ukinori/flightcontroller/placement-preview.png

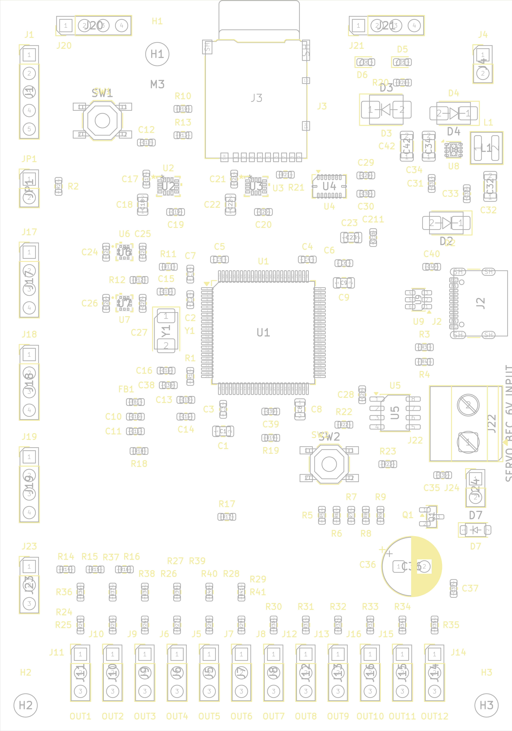
placement-preview.png
