ukinori/flightcontroller/CRYSTAL-DECOUPLING-BOM.csv

Reference | Value | Voltage | Dielectric | Tolerance | Manufacturer | MPN | Footprint
C17 | 100n | 25V | X7R | 10% | Murata | GRM188R71E104KA01D | Capacitor_SMD:C_0603_1608Metric
C21 | 100n | 25V | X7R | 10% | Murata | GRM188R71E104KA01D | Capacitor_SMD:C_0603_1608Metric
C28 | 100n | 25V | X7R | 10% | Murata | GRM188R71E104KA01D | Capacitor_SMD:C_0603_1608Metric
C18 | 2.2u | 16V | X7R | 10% | Murata | GRM21BR71C225KA12L | Capacitor_SMD:C_0805_2012Metric
C22 | 2.2u | 16V | X7R | 10% | Murata | GRM21BR71C225KA12L | Capacitor_SMD:C_0805_2012Metric
C15 | 18p | 50V | C0G | 5% | Murata | GRM1885C1H180JA01D | Capacitor_SMD:C_0603_1608Metric
C16 | 18p | 50V | C0G | 5% | Murata | GRM1885C1H180JA01D | Capacitor_SMD:C_0603_1608Metric
Y1 | 8MHz |  |  |  | Abracon | ABM3-8.000MHZ-12-D4Y-T | Crystal:Crystal_SMD_Abracon_ABM3-2Pin_5.0x3.2mm
