ukinori/flightcontroller/POWER-CAPACITORS-BOM.csv

Reference | Value | Voltage | Dielectric | Tolerance | Manufacturer | MPN | Footprint
C31 | 100n | 25V | X7R | 10% | Murata | GRM188R71E104KA01D | Capacitor_SMD:C_0603_1608Metric
C33 | 100n | 25V | X7R | 10% | Murata | GRM188R71E104KA01D | Capacitor_SMD:C_0603_1608Metric
C32 | 22u | 10V | X7R | 10% | Murata | GRM31CR71A226KE15L | Capacitor_SMD:C_1206_3216Metric
C34 | 10u | 25V | X7R | 10% | Murata | GRM31CR71E106KA12L | Capacitor_SMD:C_1206_3216Metric
C42 | 10u | 25V | X7R | 10% | Murata | GRM31CR71E106KA12L | Capacitor_SMD:C_1206_3216Metric
