ukinori/flightcontroller/models/BMP390-envelope.step

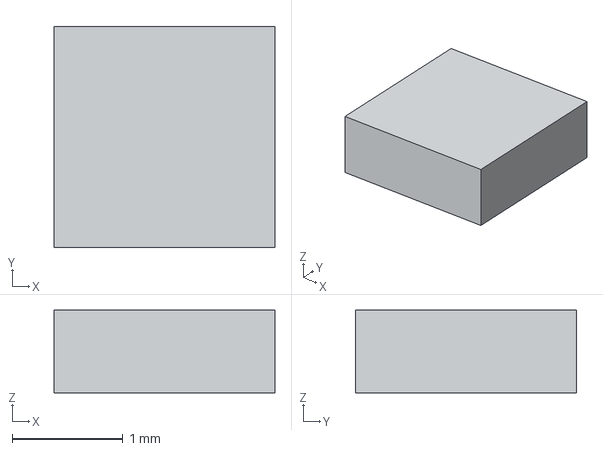
[picture p3: CAD file, 2026-10-22]
models/BMP390-envelope.step
2.00 x 2.00 x 0.75 mm
