ukinori/flightcontroller/models/ICM42688-envelope.step

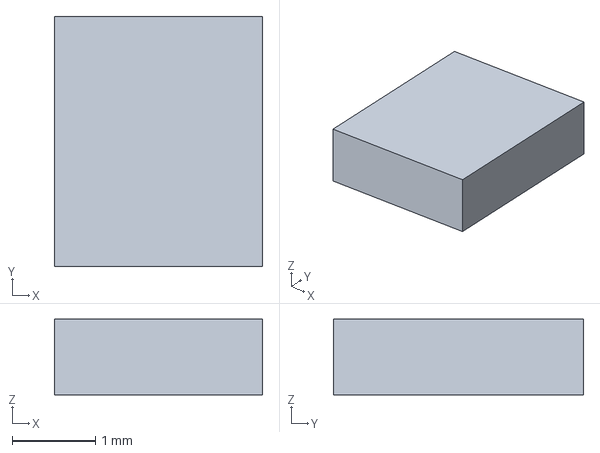
[picture p4: CAD file, 2026-10-22]
models/ICM42688-envelope.step
2.50 x 3.00 x 0.91 mm
