ukinori/flightcontroller/flightcontroller.kicad_pcb

## KiCad design flightcontroller.kicad_pcb (2026-10-22)

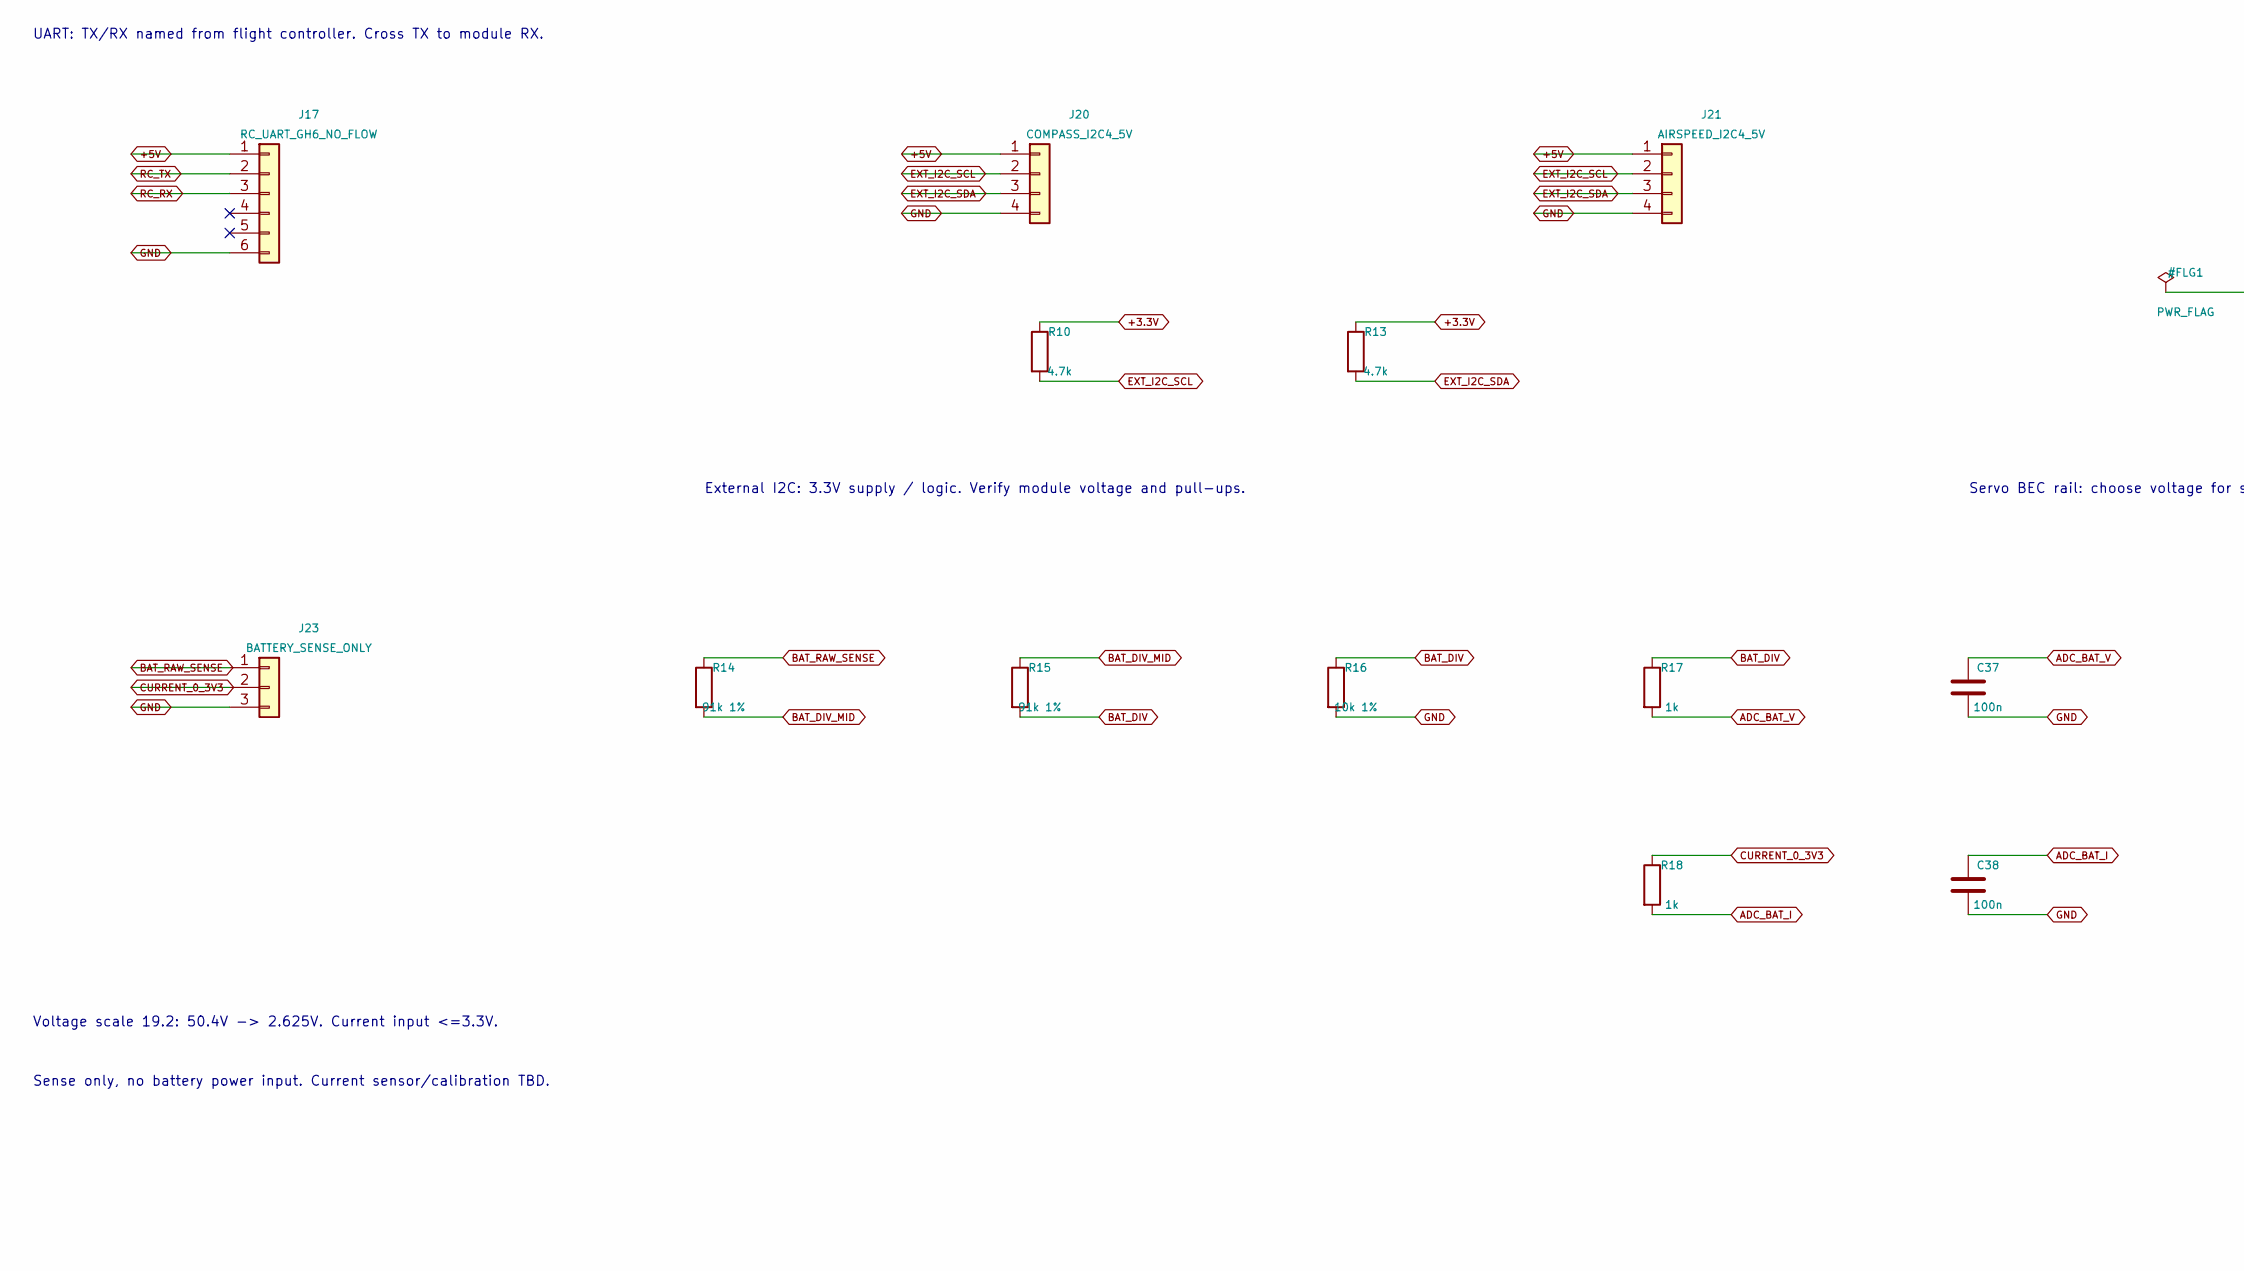
[picture p5: schematic interfaces.kicad_sch, part in row 1, column 1]

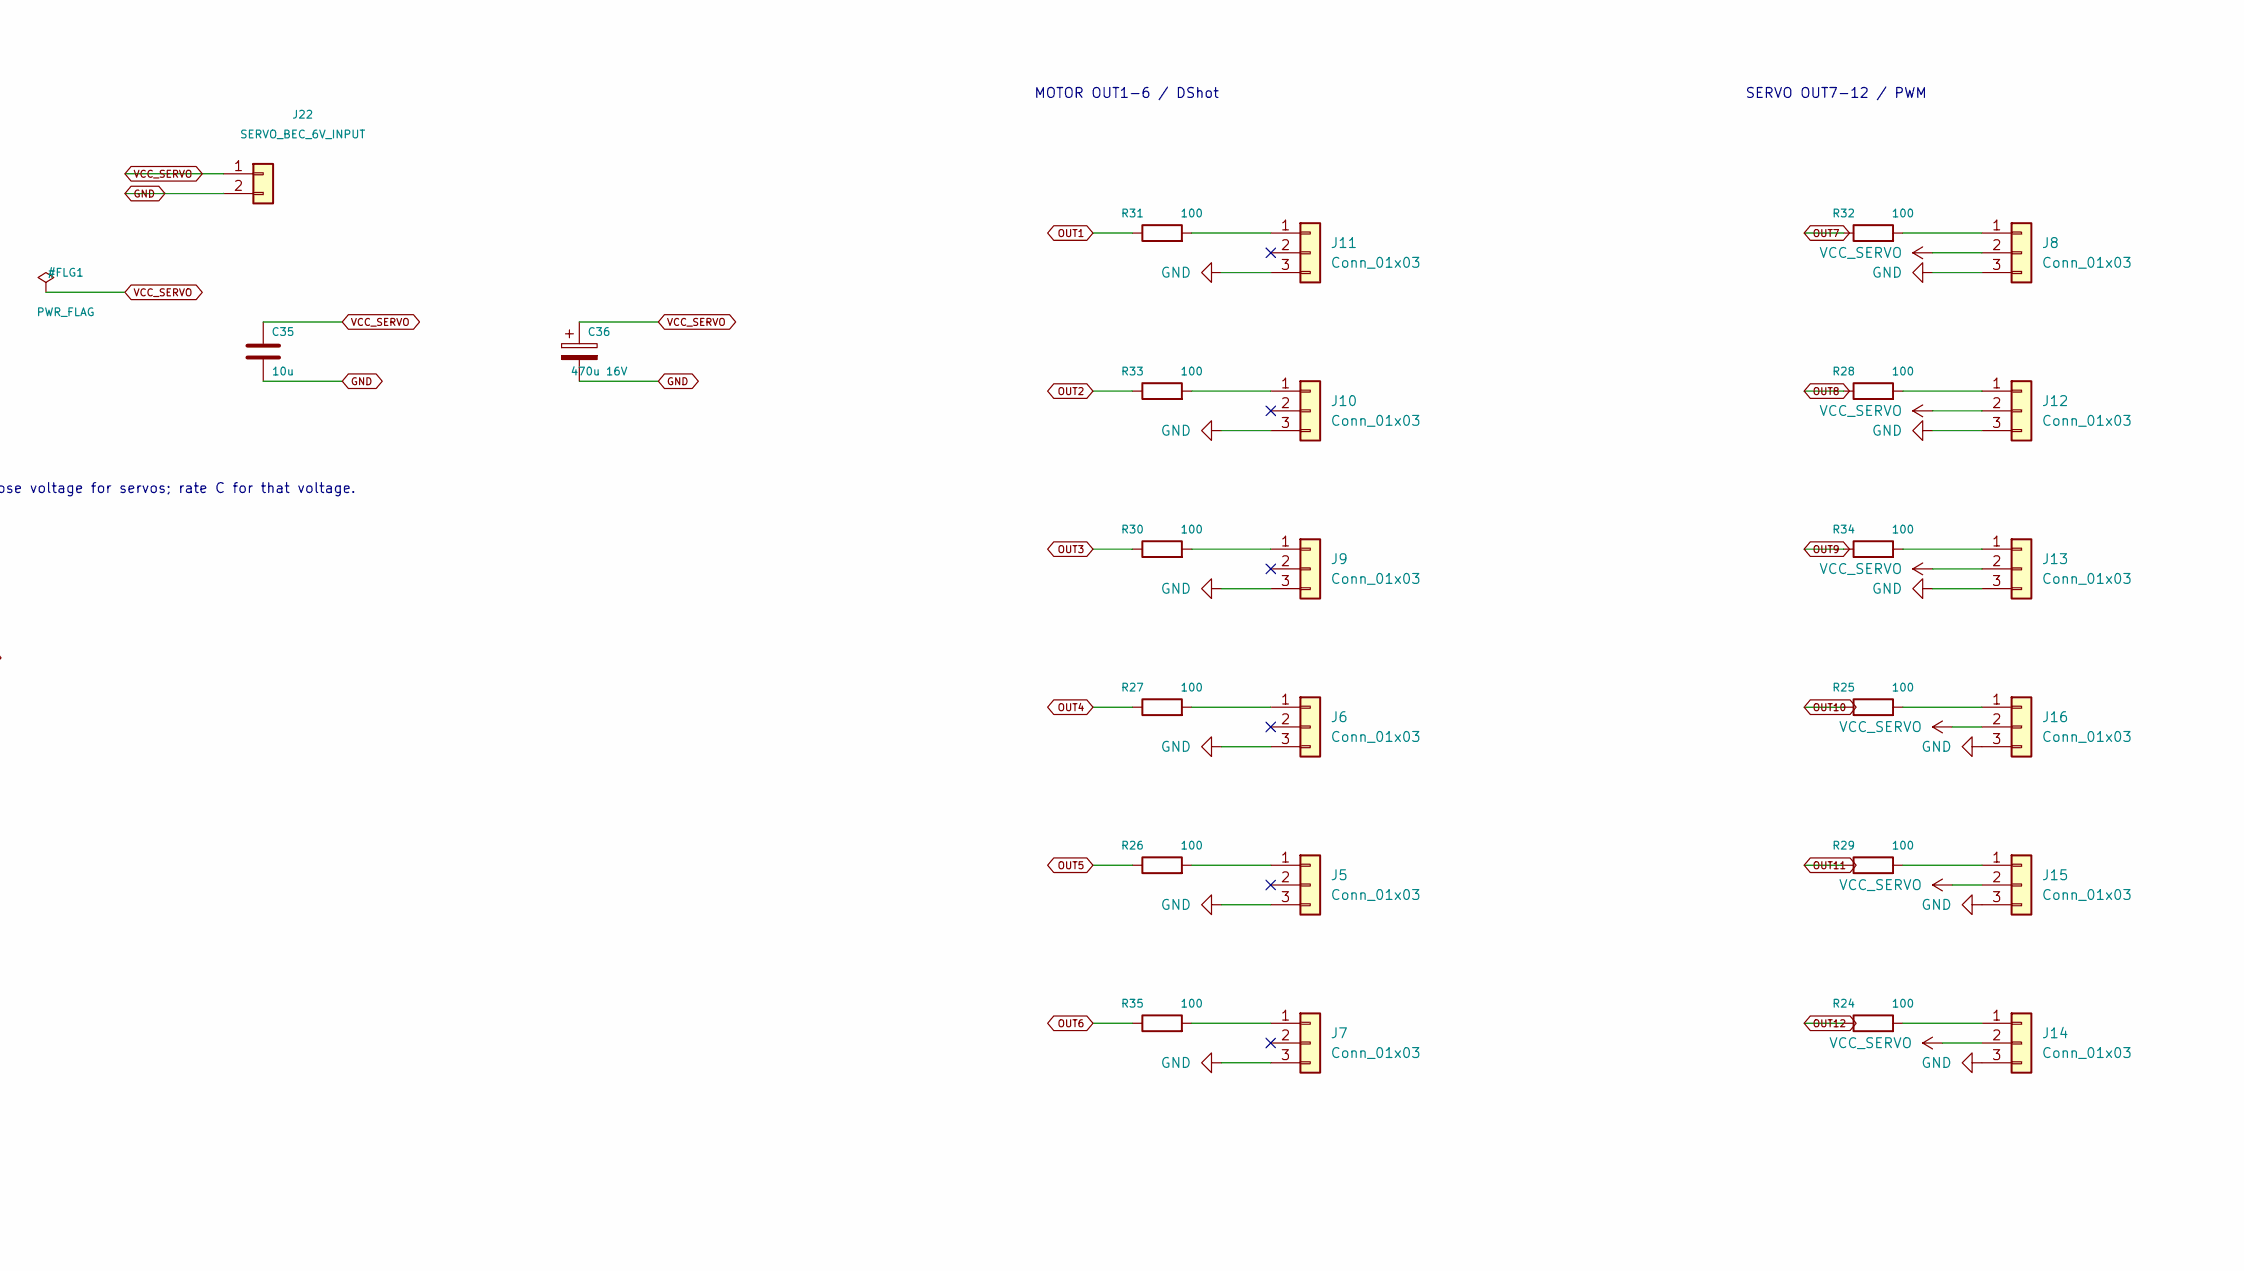
[picture p6: schematic interfaces.kicad_sch, part in row 1, column 2]

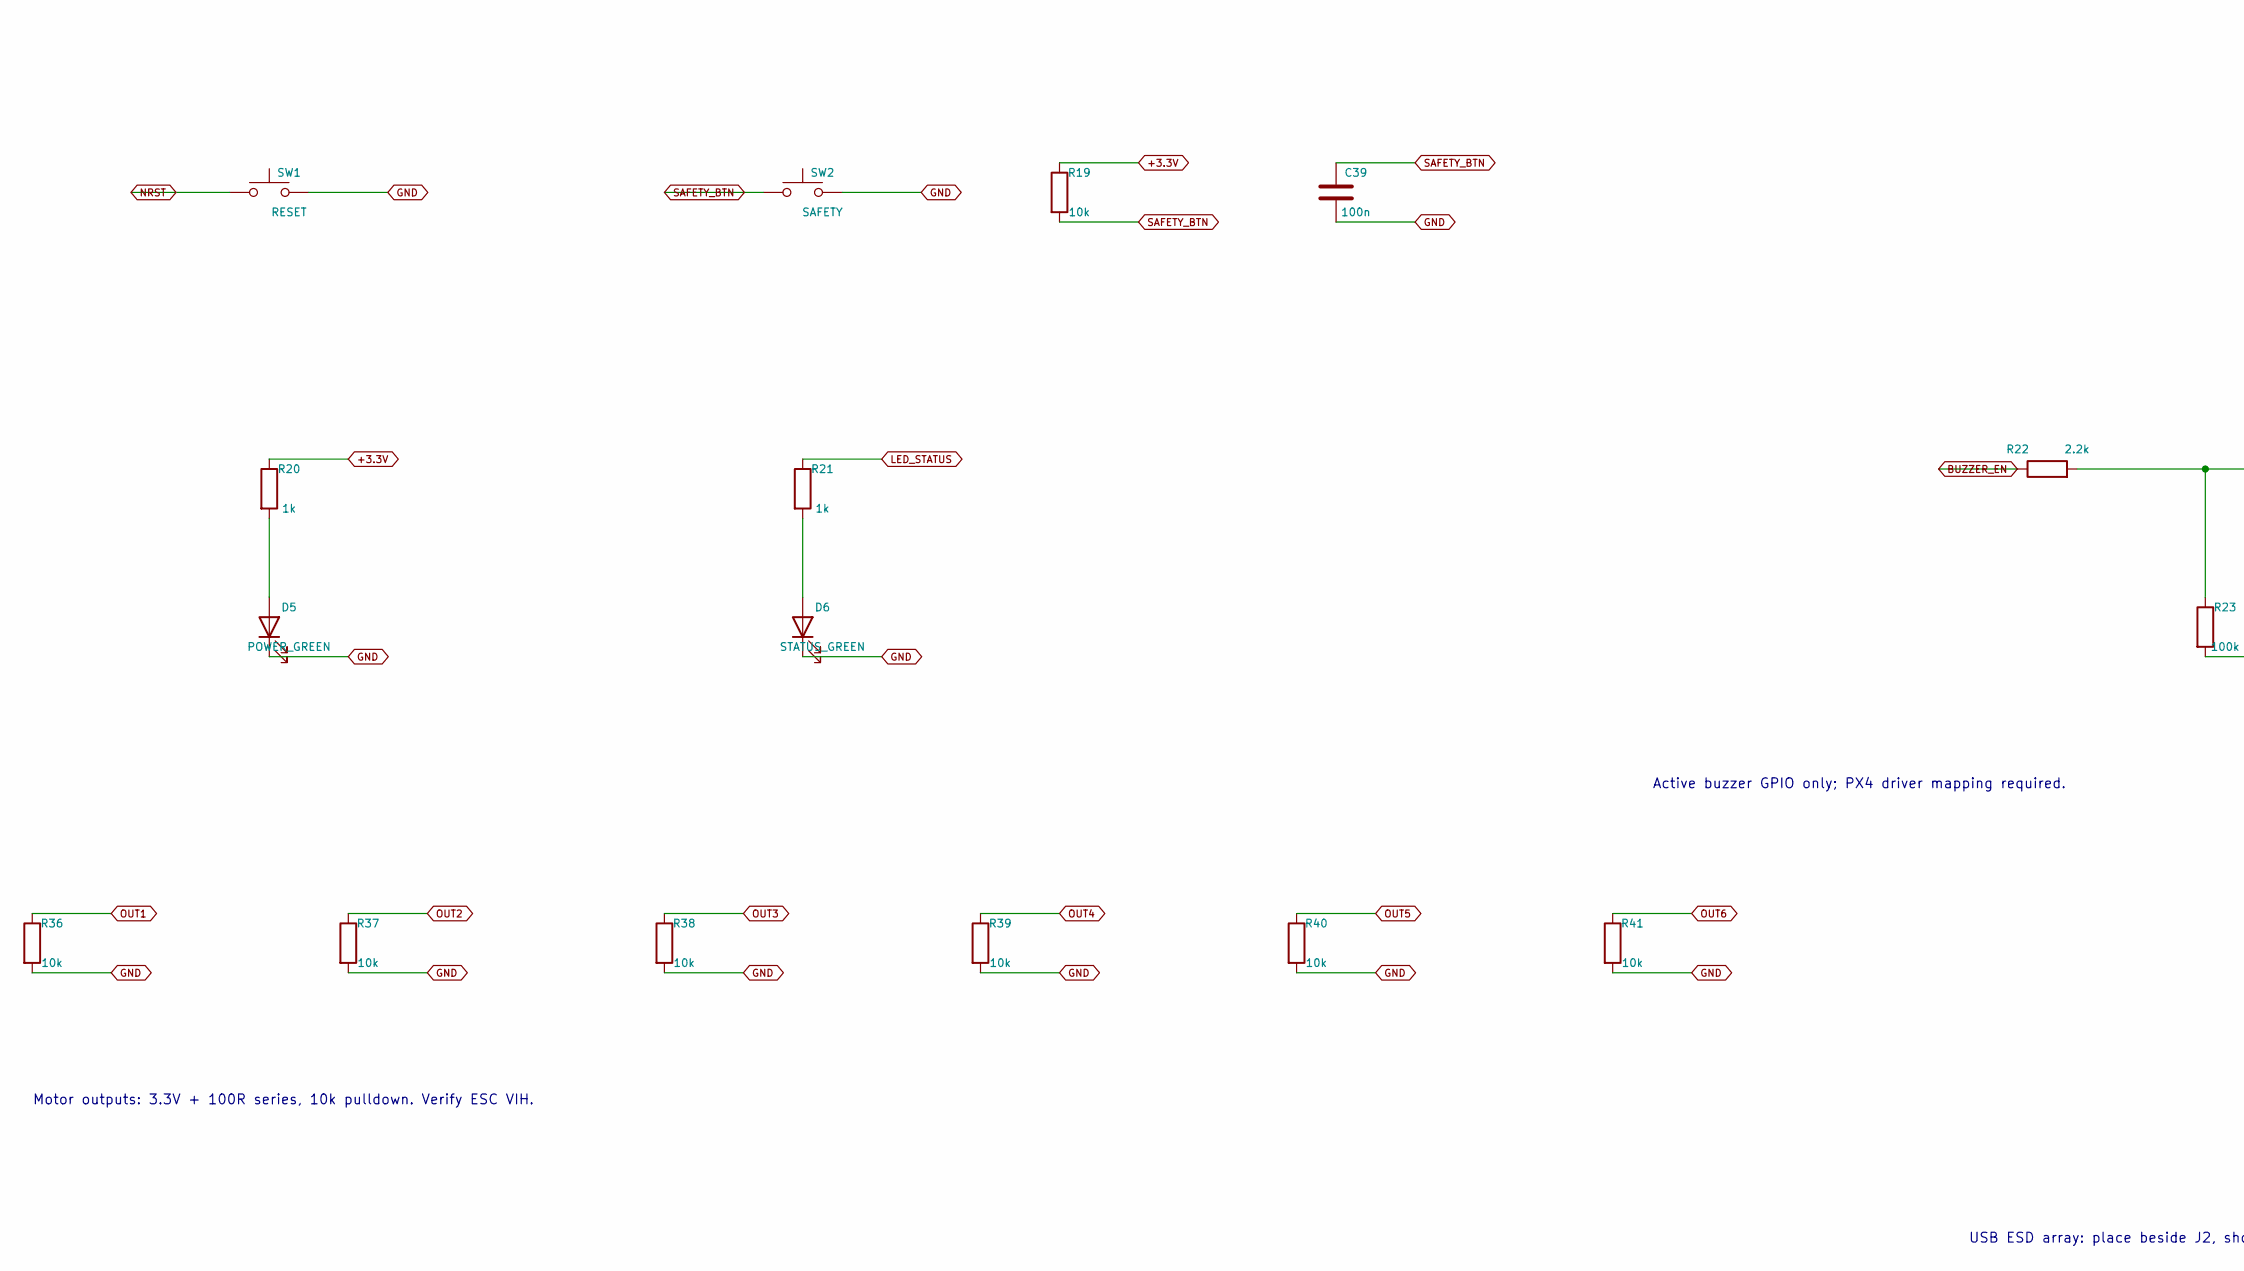
[picture p7: schematic interfaces.kicad_sch, part in row 2, column 1]

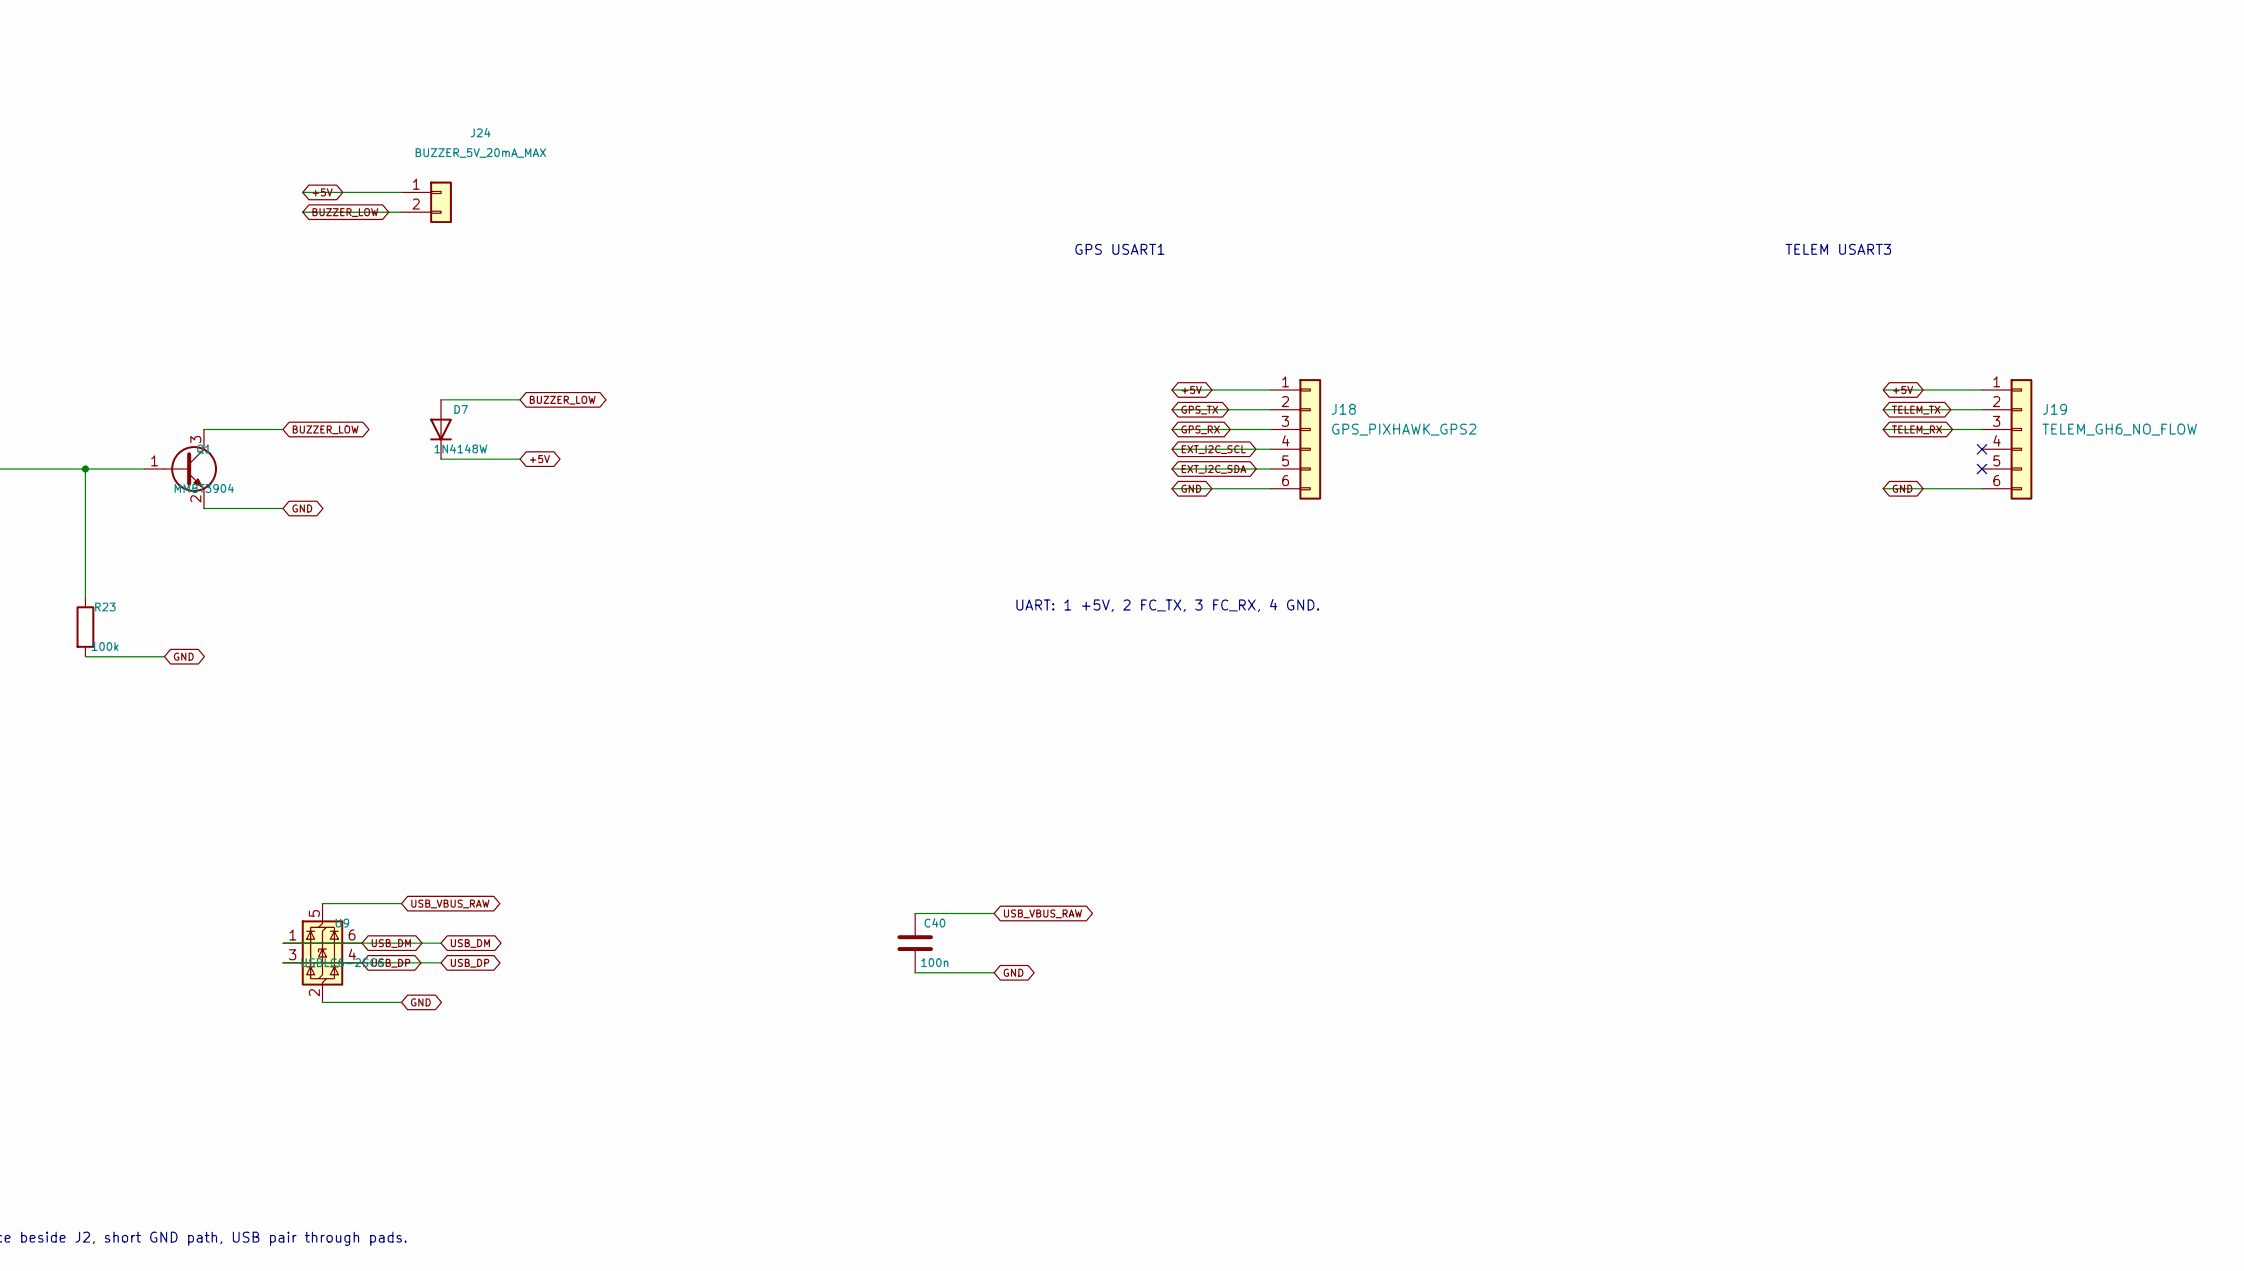
[picture p8: schematic interfaces.kicad_sch, part in row 2, column 2]

Parts:
C35: 10u; C_0603_1608Metric
C36: 470u 16V; CP_Radial_D8.0mm_P3.50mm
C37, C38, C39, C40: 100n; C_0603_1608Metric
D5: POWER_GREEN; LED_0603_1608Metric
D6: STATUS_GREEN; LED_0603_1608Metric
D7: 1N4148W; D_SOD-123
J5, J6, J7, J8, J9, J10, J11, J12, J13, J14, J15, J16: Conn_01x03; PinHeader_1x03_P2.54mm_Vertical
J17: RC_UART_GH6_NO_FLOW; JST_GH_SM06B-GHS-TB_1x06-1MP_P1.25mm_Horizontal
J18: GPS_PIXHAWK_GPS2; JST_GH_SM06B-GHS-TB_1x06-1MP_P1.25mm_Horizontal
J19: TELEM_GH6_NO_FLOW; JST_GH_SM06B-GHS-TB_1x06-1MP_P1.25mm_Horizontal
J20: COMPASS_I2C4_5V; JST_GH_SM04B-GHS-TB_1x04-1MP_P1.25mm_Horizontal
J21: AIRSPEED_I2C4_5V; JST_GH_SM04B-GHS-TB_1x04-1MP_P1.25mm_Horizontal
J22: SERVO_BEC_6V_INPUT; TerminalBlock_Phoenix_MKDS-1,5-2-5.08_1x02_P5.08mm_Horizont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; MPN 1715721
J23: BATTERY_SENSE_ONLY; PinHeader_1x03_P2.54mm_Vertical
J24: BUZZER_5V_20mA_MAX; JST_GH_SM02B-GHS-TB_1x02-1MP_P1.25mm_Horizontal
Q1: MMBT3904; SOT-23
R10, R13: 4.7k; R_0603_1608Metric
R14, R15: 91k 1%; R_0603_1608Metric
R16: 10k 1%; R_0603_1608Metric
R17, R18, R20, R21: 1k; R_0603_1608Metric
R19, R36, R37, R38, R39, R40, R41: 10k; R_0603_1608Metric
R22: 2.2k; R_0603_1608Metric
R23: 100k; R_0603_1608Metric
R24, R25, R26, R27, R28, R29, R30, R31, R32, R33, R34, R35: 100; R_0603_1608Metric
SW1: RESET; SW_SPST_TL3342
SW2: SAFETY; SW_SPST_TL3342
U9: USBLC6-2SC6; SOT-23-6

Connections:
+3.3V: R10.1, R13.1, R19.1, R20.1; also elsewhere on the board
+5V: D7.1 (K), J17.1, J18.1, J19.1, J20.1, J21.1, J24.1; also elsewhere on the board
ADC_BAT_I: C38.1, R18.2; also elsewhere on the board
ADC_BAT_V: C37.1, R17.2; also elsewhere on the board
BAT_DIV: R15.2, R16.1, R17.1
BAT_DIV_MID: R14.2, R15.1
BAT_RAW_SENSE: J23.1, R14.1
BUZZER_EN: R22.1; also elsewhere on the board
BUZZER_LOW: D7.2 (A), J24.2, Q1.3 (C)
CURRENT_0_3V3: J23.2, R18.1
EXT_I2C_SCL: J18.4, J20.2, J21.2, R10.2; also elsewhere on the board
EXT_I2C_SDA: J18.5, J20.3, J21.3, R13.2; also elsewhere on the board
GND: C35.2, C36.2, C37.2, C38.2, C39.2, C40.2, D5.1 (K), D6.1 (K), J5.3, J6.3, J7.3, J8.3, J9.3, J10.3, J11.3, J12.3, J13.3, J14.3, J15.3, J16.3, J17.6, J18.6, J19.6, J20.4, J21.4, J22.2, J23.3, Q1.2 (E), R16.2, R23.2, R36.2, R37.2, R38.2, R39.2, R40.2, R41.2, SW1.2, SW2.2, U9.2 (GND); also elsewhere on the board
GPS_RX: J18.3; also elsewhere on the board
GPS_TX: J18.2; also elsewhere on the board
LED_STATUS: R21.1; also elsewhere on the board
NRST: SW1.1; also elsewhere on the board
unnamed: D5.2 (A), R20.2
unnamed: D6.2 (A), R21.2
unnamed: J5.1, R26.2
unnamed: J6.1, R27.2
unnamed: J7.1, R35.2
unnamed: J8.1, R32.2
unnamed: J9.1, R30.2
unnamed: J10.1, R33.2
unnamed: J11.1, R31.2
unnamed: J12.1, R28.2
unnamed: J13.1, R34.2
unnamed: J14.1, R24.2
unnamed: J15.1, R29.2
unnamed: J16.1, R25.2
unnamed: Q1.1 (B), R22.2, R23.1
OUT1: R31.1, R36.1; also elsewhere on the board
OUT2: R33.1, R37.1; also elsewhere on the board
OUT3: R30.1, R38.1; also elsewhere on the board
OUT4: R27.1, R39.1; also elsewhere on the board
OUT5: R26.1, R40.1; also elsewhere on the board
OUT6: R35.1, R41.1; also elsewhere on the board
OUT7: R32.1; also elsewhere on the board
OUT8: R28.1; also elsewhere on the board
OUT9: R34.1; also elsewhere on the board
OUT10: R25.1; also elsewhere on the board
OUT11: R29.1; also elsewhere on the board
OUT12: R24.1; also elsewhere on the board
RC_RX: J17.3; also elsewhere on the board
RC_TX: J17.2; also elsewhere on the board
SAFETY_BTN: C39.1, R19.2, SW2.1; also elsewhere on the board
TELEM_RX: J19.3; also elsewhere on the board
TELEM_TX: J19.2; also elsewhere on the board
USB_DM: U9.1 (I/O1), U9.6 (I/O1); also elsewhere on the board
USB_DP: U9.3 (I/O2), U9.4 (I/O2); also elsewhere on the board
USB_VBUS_RAW: C40.1, U9.5 (VBUS); also elsewhere on the board
VCC_SERVO: C35.1, C36.1, J8.2, J12.2, J13.2, J14.2, J15.2, J16.2, J22.1

Notes on the sheet:
External I2C: 3.3V supply / logic. Verify module voltage and pull-ups.
Motor outputs: 3.3V + 100R series, 10k pulldown. Verify ESC VIH.
UART: TX/RX named from flight controller. Cross TX to module RX.
GPS USART1
Voltage scale 19.2: 50.4V -> 2.625V. Current input <=3.3V.
UART: 1 +5V, 2 FC_TX, 3 FC_RX, 4 GND.
TELEM USART3
SERVO OUT7-12 / PWM
Servo BEC rail: choose voltage for servos; rate C for that voltage.
USB ESD array: place beside J2, short GND path, USB pair through pads.
Sense only, no battery power input. Current sensor/calibration TBD.
Active buzzer GPIO only; PX4 driver mapping required.
MOTOR OUT1-6 / DShot

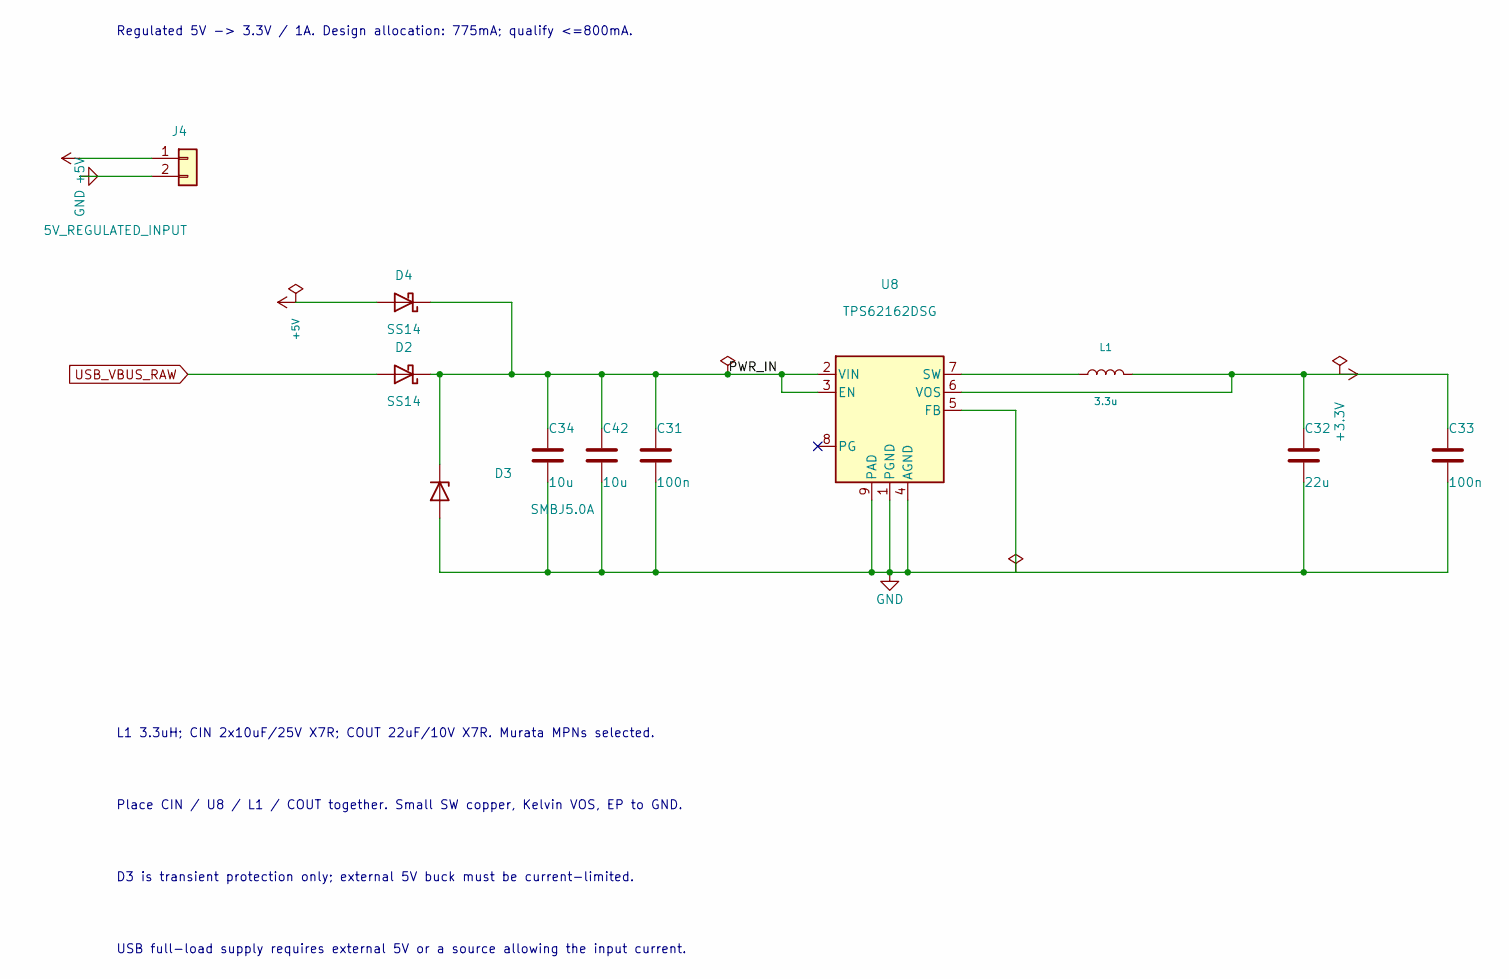
[picture p9: schematic power.kicad_sch]

Parts:
C31, C33: 100n; C_0603_1608Metric; Voltage 25V; Tolerance 10%; MPN GRM188R71E104KA01D
C32: 22u; C_1206_3216Metric; Voltage 10V; Tolerance 10%; MPN GRM31CR71A226KE15L
C34, C42: 10u; C_1206_3216Metric; Voltage 25V; Tolerance 10%; MPN GRM31CR71E106KA12L
D2, D4: SS14; D_SMA
D3: SMBJ5.0A; D_SMB; MPN SMBJ5.0A-E3/52
J4: 5V_REGULATED_INPUT; PinHeader_1x02_P2.54mm_Vertical
L1: 3.3u; L_Coilcraft_XAL4030-XXX; MPN XAL4030-332MEC
U8: TPS62162DSG; WSON-8-1EP_2x2mm_P0.5mm_EP0.9x1.6mm_ThermalVias; MPN TPS62162DSGR

Connections:
+3.3V: C32.1, C33.1, L1.2, U8.6 (VOS); also elsewhere on the board
+5V: D4.2 (A), J4.1; also elsewhere on the board
/power/PWR_IN: C31.1, C34.1, C42.1, D2.1 (K), D3.1 (K), D4.1 (K), U8.2 (VIN), U8.3 (EN)
GND: C31.2, C32.2, C33.2, C34.2, C42.2, D3.2 (A), J4.2, U8.1 (PGND), U8.4 (AGND), U8.5 (FB), U8.9 (PAD); also elsewhere on the board
unnamed: L1.1, U8.7 (SW)
USB_VBUS_RAW: D2.2 (A); also elsewhere on the board

Notes on the sheet:
Place CIN / U8 / L1 / COUT together. Small SW copper, Kelvin VOS, EP to GND.
L1 3.3uH; CIN 2x10uF/25V X7R; COUT 22uF/10V X7R. Murata MPNs selected.
USB full-load supply requires external 5V or a source allowing the input current.
Regulated 5V -> 3.3V / 1A. Design allocation: 775mA; qualify <=800mA.
D3 is transient protection only; external 5V buck must be current-limited.

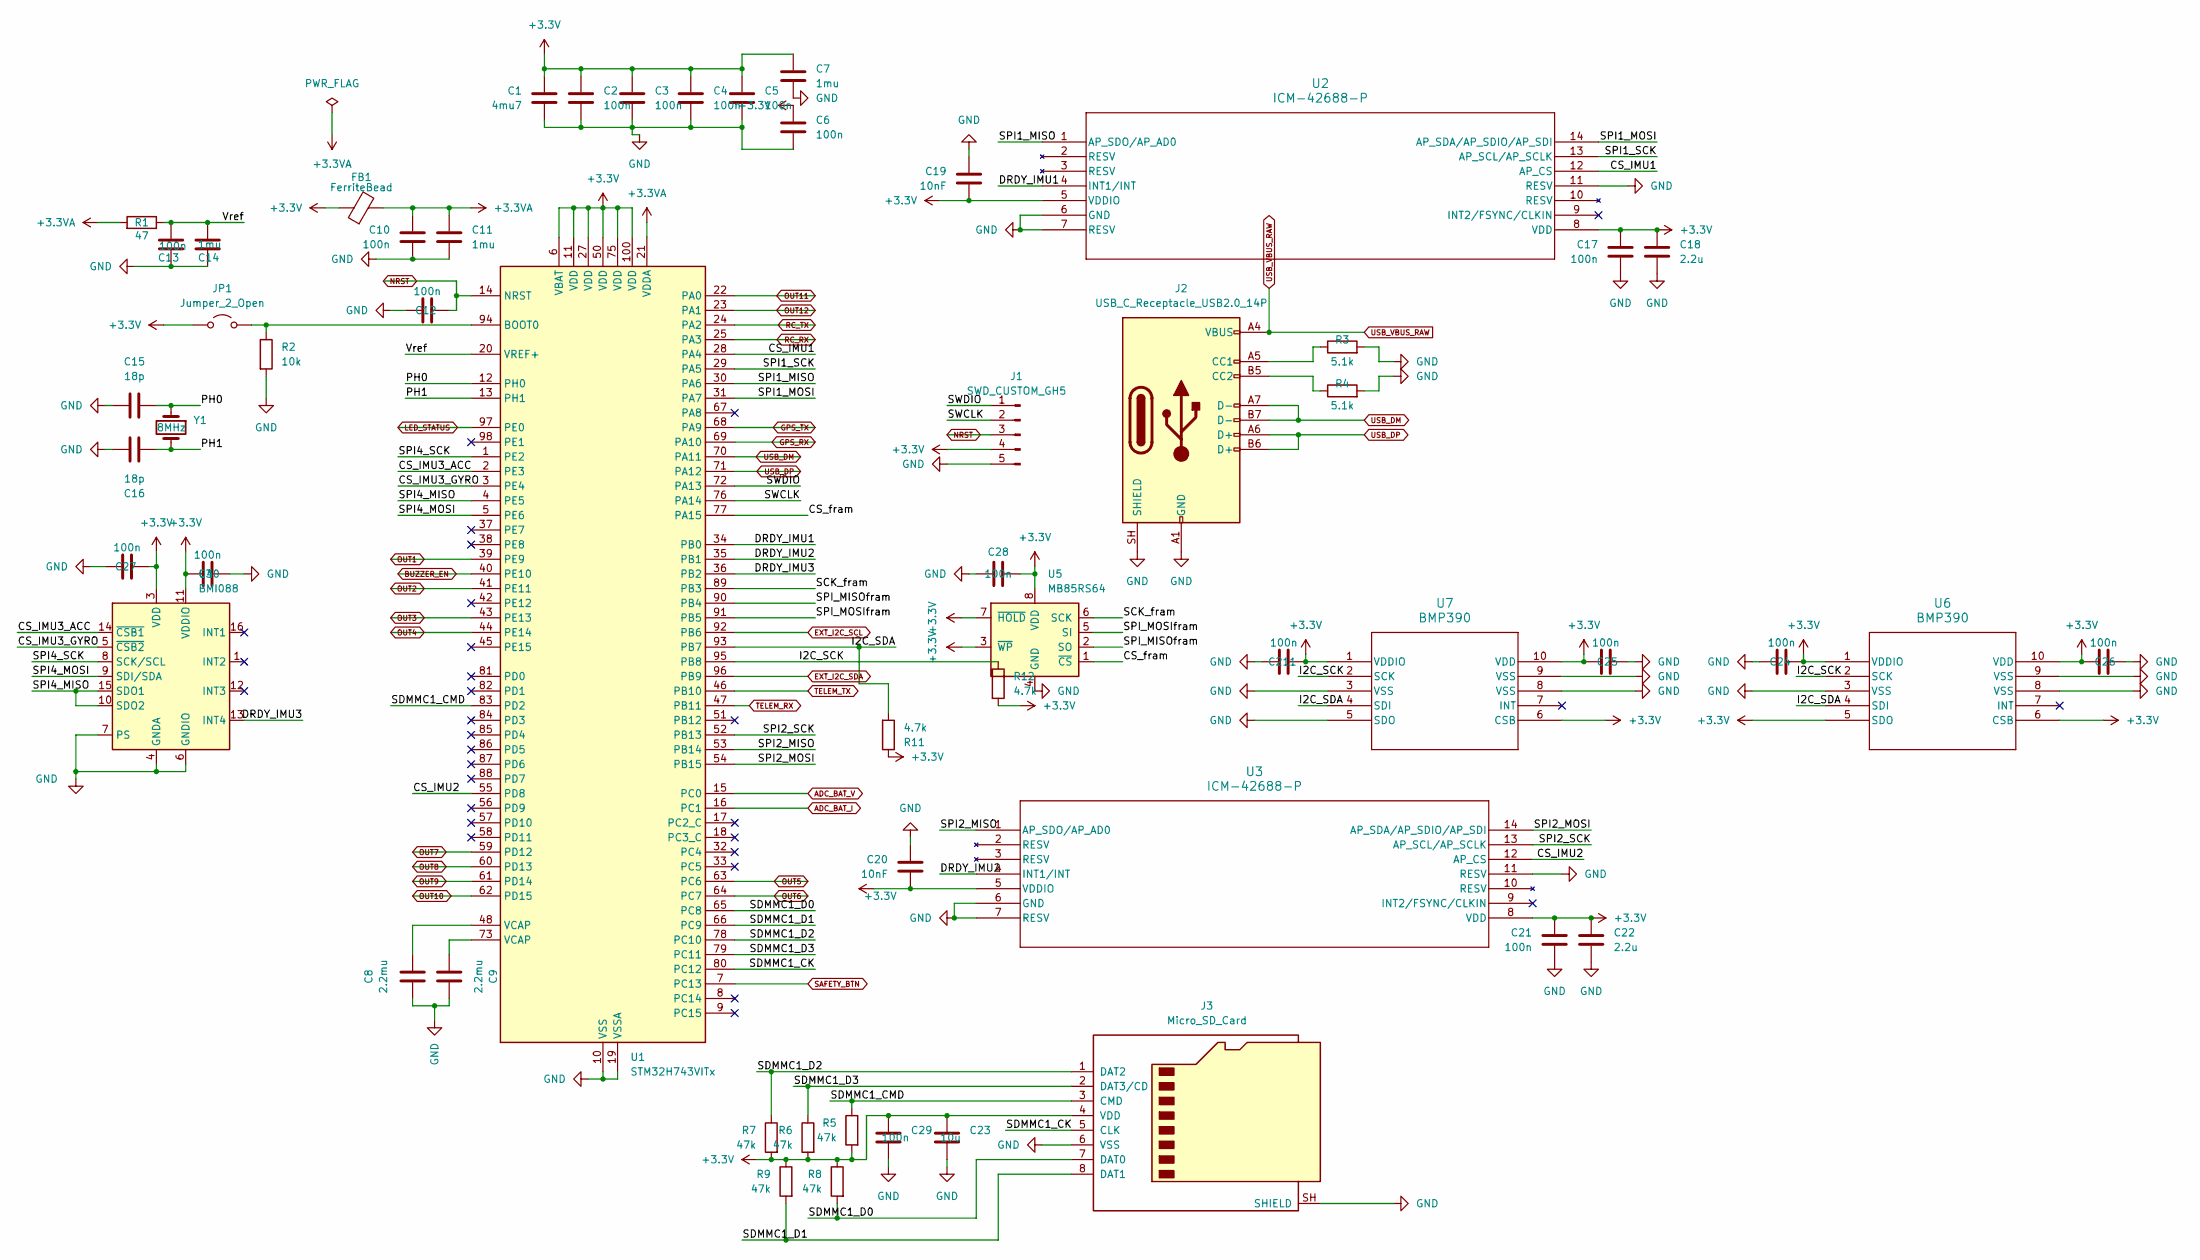
[picture p10: schematic untitled.kicad_sch]

Parts:
C1: 4mu7; C_0805_2012Metric
C2, C3, C4, C5, C6, C10, C12, C13, C24, C25, C26, C27, C29, C30, C211: 100n; C_0603_1608Metric
C7, C11, C14: 1mu; C_0603_1608Metric
C8, C9: 2.2mu; C_0805_2012Metric
C15, C16: 18p; C_0603_1608Metric; Voltage 50V; Tolerance 5%; MPN GRM1885C1H180JA01D
C17, C21, C28: 100n; C_0603_1608Metric; Voltage 25V; Tolerance 10%; MPN GRM188R71E104KA01D
C18, C22: 2.2u; C_0805_2012Metric; Voltage 16V; Tolerance 10%; MPN GRM21BR71C225KA12L
C19, C20: 10nF; C_0603_1608Metric
C23: 10u; C_0805_2012Metric
FB1: FerriteBead; L_0603_1608Metric; MPN BLM18PG121SN1D
J1: SWD_CUSTOM_GH5; JST_GH_SM05B-GHS-TB_1x05-1MP_P1.25mm_Horizontal
J2: USB_C_Receptacle_USB2.0_14P; USB_C_Receptacle_GCT_USB4105-xx-A_16P_TopMnt_Horizontal; MPN USB4105-GF-A
J3: Micro_SD_Card; microSD_HC_Hirose_DM3AT-SF-PEJM5; MPN DM3AT-SF-PEJM5
JP1: Jumper_2_Open; PinHeader_1x02_P2.54mm_Vertical
R1: 47; R_0603_1608Metric
R2: 10k; R_0603_1608Metric
R3, R4: 5.1k; R_0603_1608Metric
R5, R6, R7, R8, R9: 47k; R_0603_1608Metric
R11, R12: 4.7k; R_0603_1608Metric
U1: STM32H743VITx; LQFP-100_14x14mm_P0.5mm
U2, U3: ICM-42688-P; LGA14_2P5X3X0P91_TDK
U4: BMI088; Bosch_LGA-16_4.5x3mm_P0.5mm_LayoutBorder7x1y_ClockwisePinNu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
U5: MB85RS64; SOIC-8_3.9x4.9mm_P1.27mm; MPN MB85RS64PNF-G-JNE1
U6, U7: BMP390; 10LGA_2X2X0p75_BOS
Y1: 8MHz; Crystal_SMD_Abracon_ABM3-2Pin_5.0x3.2mm; MPN ABM3-8.000MHZ-12-D4Y-T

Connections:
+3.3V: C1.1, C2.1, C3.1, C4.1, C5.1, C6.1, C7.1, C17.1, C18.1, C19.2, C20.2, C21.1, C22.1, C23.1, C24.1, C25.1, C26.1, C27.1, C28.2, C29.1, C30.1, C211.1, FB1.1, J1.4, J3.4 (VDD), JP1.1 (A), R5.2, R6.2, R7.2, R8.1, R9.1, R11.1, R12.2, U1.6 (VBAT), U1.11 (VDD), U1.27 (VDD), U1.50 (VDD), U1.75 (VDD), U1.100 (VDD), U2.5 (VDDIO), U2.8 (VDD), U3.5 (VDDIO), U3.8 (VDD), U4.3 (VDD), U4.11 (VDDIO), U5.3 (~WP), U5.7 (~HOLD), U5.8 (VDD), U6.1 (VDDIO), U6.5 (SDO), U6.6 (CSB), U6.10 (VDD), U7.1 (VDDIO), U7.6 (CSB), U7.10 (VDD); also elsewhere on the board
+3.3VA: C10.1, C11.1, FB1.2, R1.2, U1.21 (VDDA)
/MCU/CS_IMU1: U1.28 (PA4), U2.12 (AP_CS)
/MCU/CS_IMU2: U1.55 (PD8), U3.12 (AP_CS)
/MCU/CS_IMU3_ACC: U1.2 (PE3), U4.14 (~CSB1)
/MCU/CS_IMU3_GYRO: U1.3 (PE4), U4.5 (~CSB2)
/MCU/CS_fram: U1.77 (PA15), U5.1 (~CS)
/MCU/DRDY_IMU1: U1.34 (PB0), U2.4 (INT1/INT)
/MCU/DRDY_IMU2: U1.35 (PB1), U3.4 (INT1/INT)
/MCU/DRDY_IMU3: U1.36 (PB2), U4.13 (INT4)
/MCU/I2C_SCK: R12.1, U1.95 (PB8), U6.2 (SCK), U7.2 (SCK)
/MCU/I2C_SDA: R11.2, U1.93 (PB7), U6.4 (SDI), U7.4 (SDI)
/MCU/PH0: C15.1, U1.12 (PH0), Y1.1
/MCU/PH1: C16.1, U1.13 (PH1), Y1.2
/MCU/SCK_fram: U1.89 (PB3), U5.6 (SCK)
/MCU/SDMMC1_CK: J3.5 (CLK), U1.80 (PC12)
/MCU/SDMMC1_CMD: J3.3 (CMD), R5.1, U1.83 (PD2)
/MCU/SDMMC1_D0: J3.7 (DAT0), R8.2, U1.65 (PC8)
/MCU/SDMMC1_D1: J3.8 (DAT1), R9.2, U1.66 (PC9)
/MCU/SDMMC1_D2: J3.1 (DAT2), R7.1, U1.78 (PC10)
/MCU/SDMMC1_D3: J3.2 (DAT3/CD), R6.1, U1.79 (PC11)
/MCU/SPI1_MISO: U1.30 (PA6), U2.1 (AP_SDO/AP_AD0)
/MCU/SPI1_MOSI: U1.31 (PA7), U2.14 (AP_SDA/AP_SDIO/AP_SDI)
/MCU/SPI1_SCK: U1.29 (PA5), U2.13 (AP_SCL/AP_SCLK)
/MCU/SPI2_MISO: U1.53 (PB14), U3.1 (AP_SDO/AP_AD0)
/MCU/SPI2_MOSI: U1.54 (PB15), U3.14 (AP_SDA/AP_SDIO/AP_SDI)
/MCU/SPI2_SCK: U1.52 (PB13), U3.13 (AP_SCL/AP_SCLK)
/MCU/SPI4_MISO: U1.4 (PE5), U4.10 (SDO2), U4.15 (SDO1)
/MCU/SPI4_MOSI: U1.5 (PE6), U4.9 (SDI/SDA)
/MCU/SPI4_SCK: U1.1 (PE2), U4.8 (SCK/SCL)
/MCU/SPI_MISOfram: U1.90 (PB4), U5.2 (SO)
/MCU/SPI_MOSIfram: U1.91 (PB5), U5.5 (SI)
/MCU/SWCLK: J1.2, U1.76 (PA14)
/MCU/SWDIO: J1.1, U1.72 (PA13)
/MCU/Vref: C13.1, C14.1, R1.1, U1.20 (VREF+)
ADC_BAT_I: U1.16 (PC1); also elsewhere on the board
ADC_BAT_V: U1.15 (PC0); also elsewhere on the board
BUZZER_EN: U1.40 (PE10); also elsewhere on the board
EXT_I2C_SCL: U1.92 (PB6); also elsewhere on the board
EXT_I2C_SDA: U1.96 (PB9); also elsewhere on the board
GND: C1.2, C2.2, C3.2, C4.2, C5.2, C6.2, C7.2, C8.2, C9.2, C10.2, C11.2, C12.2, C13.2, C14.2, C15.2, C16.2, C17.2, C18.2, C19.1, C20.1, C21.2, C22.2, C23.2, C24.2, C25.2, C26.2, C27.2, C28.1, C29.2, C30.2, C211.2, J1.5, J2.A1 (GND), J2.A12 (GND), J2.B1 (GND), J2.B12 (GND), J2.SH (SHIELD), J3.6 (VSS), J3.SH (SHIELD), R2.2, R3.2, R4.2, U1.10 (VSS), U1.19 (VSSA), U1.26 (VSS), U1.49 (VSS), U1.74 (VSS), U1.99 (VSS), U2.6 (GND), U2.7 (RESV), U2.11 (RESV), U3.6 (GND), U3.7 (RESV), U3.11 (RESV), U4.2 (GNDA), U4.4 (GNDA), U4.6 (GNDIO), U4.7 (PS), U5.4 (GND), U6.3 (VSS), U6.8 (VSS), U6.9 (VSS), U7.3 (VSS), U7.5 (SDO), U7.8 (VSS), U7.9 (VSS); also elsewhere on the board
GPS_RX: U1.69 (PA10); also elsewhere on the board
GPS_TX: U1.68 (PA9); also elsewhere on the board
LED_STATUS: U1.97 (PE0); also elsewhere on the board
NRST: C12.1, J1.3, U1.14 (NRST); also elsewhere on the board
unnamed: C8.1, U1.48 (VCAP)
unnamed: C9.1, U1.73 (VCAP)
unnamed: J2.A5 (CC1), R3.1
unnamed: J2.B5 (CC2), R4.1
unnamed: JP1.2 (B), R2.1, U1.94 (BOOT0)
OUT1: U1.39 (PE9); also elsewhere on the board
OUT2: U1.41 (PE11); also elsewhere on the board
OUT3: U1.43 (PE13); also elsewhere on the board
OUT4: U1.44 (PE14); also elsewhere on the board
OUT5: U1.63 (PC6); also elsewhere on the board
OUT6: U1.64 (PC7); also elsewhere on the board
OUT7: U1.59 (PD12); also elsewhere on the board
OUT8: U1.60 (PD13); also elsewhere on the board
OUT9: U1.61 (PD14); also elsewhere on the board
OUT10: U1.62 (PD15); also elsewhere on the board
OUT11: U1.22 (PA0); also elsewhere on the board
OUT12: U1.23 (PA1); also elsewhere on the board
RC_RX: U1.25 (PA3); also elsewhere on the board
RC_TX: U1.24 (PA2); also elsewhere on the board
SAFETY_BTN: U1.7 (PC13); also elsewhere on the board
TELEM_RX: U1.47 (PB11); also elsewhere on the board
TELEM_TX: U1.46 (PB10); also elsewhere on the board
USB_DM: J2.A7 (D-), J2.B7 (D-), U1.70 (PA11); also elsewhere on the board
USB_DP: J2.A6 (D+), J2.B6 (D+), U1.71 (PA12); also elsewhere on the board
USB_VBUS_RAW: J2.A4 (VBUS), J2.A9 (VBUS), J2.B4 (VBUS), J2.B9 (VBUS); also elsewhere on the board
