ukinori/flightcontroller/flightcontroller.kicad_pcb

## KiCad design flightcontroller.kicad_pcb (continued)

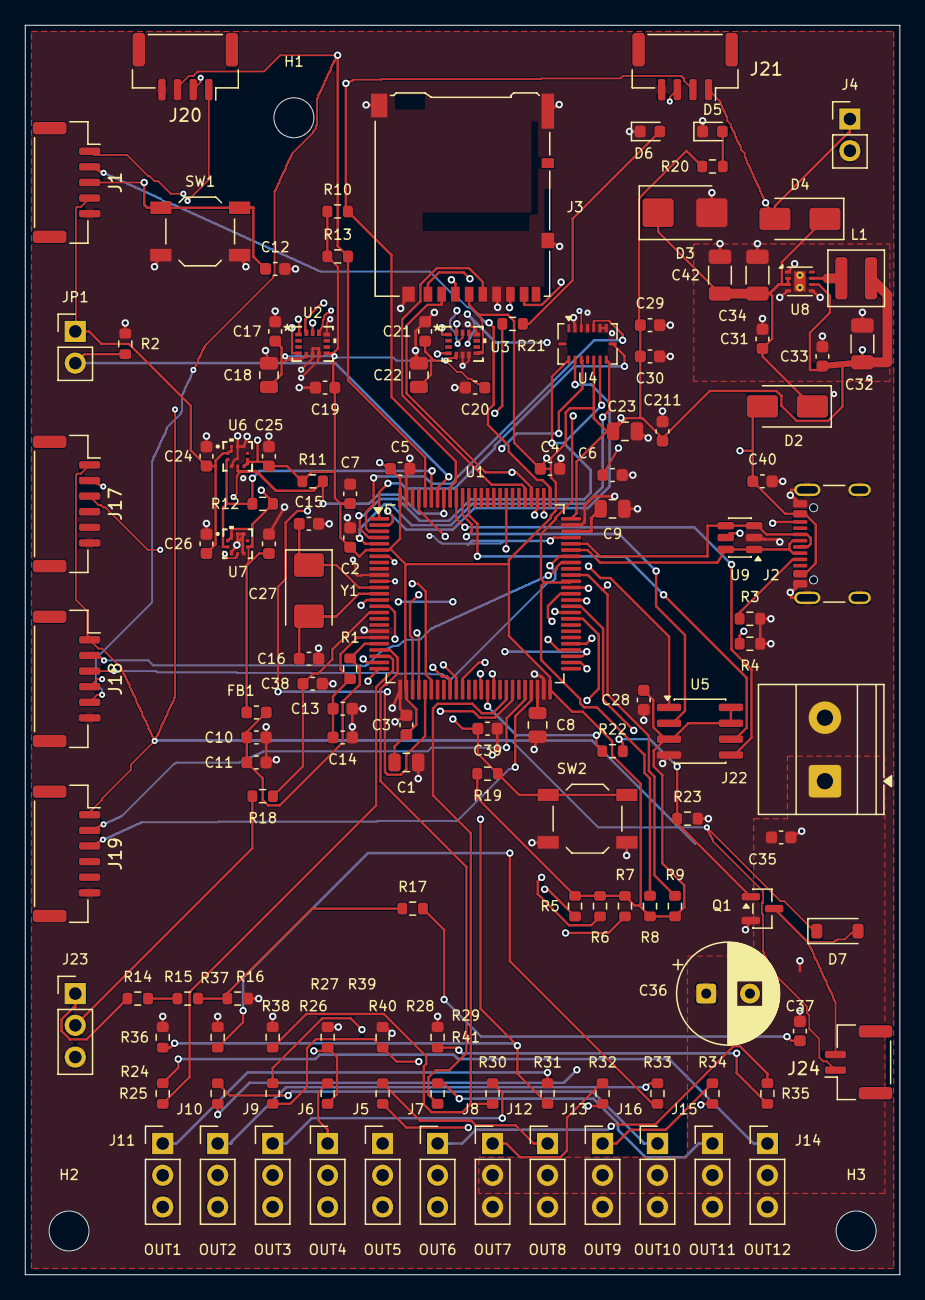
[picture p11: board flightcontroller.kicad_pcb from above]

Board: 4 copper layers, 70.0 x 100.0 mm, 132 parts (0 on the bottom side), 94 nets.

Other parts of the board:
H1, H2, H3: M3; MountingHole_3.2mm_M3
