ukinori/flightcontroller/(commit log)

2026-10-21 Publish flight controller PCB, schematics and project documentation
    [CRYSTAL-DECOUPLING-BOM.csv, FOOTPRINT-ASSIGNMENTS.csv, POWER-CAPACITORS-BOM.csv, flightcontroller.kicad_pcb, flightcontroller.kicad_sch, interfaces.kicad_sch, power.kicad_sch, untitled.kicad_sch]
2026-10-21 Add project footprint library directory
    Add README.md for project footprint library
2026-10-21 Add project-local ICM and BMP sensor footprints
2026-10-21 Add current ERC and DRC verification reports
2026-10-21 Include unfinished mesh radio hardware project
    [interfaces.kicad_sch, meshtransciever.kicad_pcb, meshtransciever.kicad_sch, power.kicad_sch, radio.kicad_sch, radio_control.kicad_sch, radio_supplies.kicad_sch, untitled.kicad_sch]
2026-10-22 Update JST-GH interfaces and add board 3D preview
    [BMP390-envelope.step, FOOTPRINT-ASSIGNMENTS.csv, ICM42688-envelope.step, JST-GH-CONNECTORS.csv, flightcontroller.kicad_pcb, interfaces.kicad_sch, untitled.kicad_sch]
